paddygoat/WEEDINATOR_2026/Code/Control_room/small-tractor-transparent-background_02.png

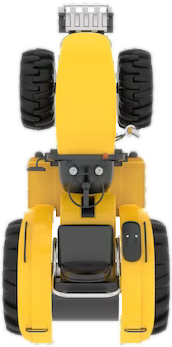
Code/Control_room/small-tractor-transparent-background_02.png
