paddygoat/WEEDINATOR_2026/Code/Control_room/tiles/tile_workshop.jpg

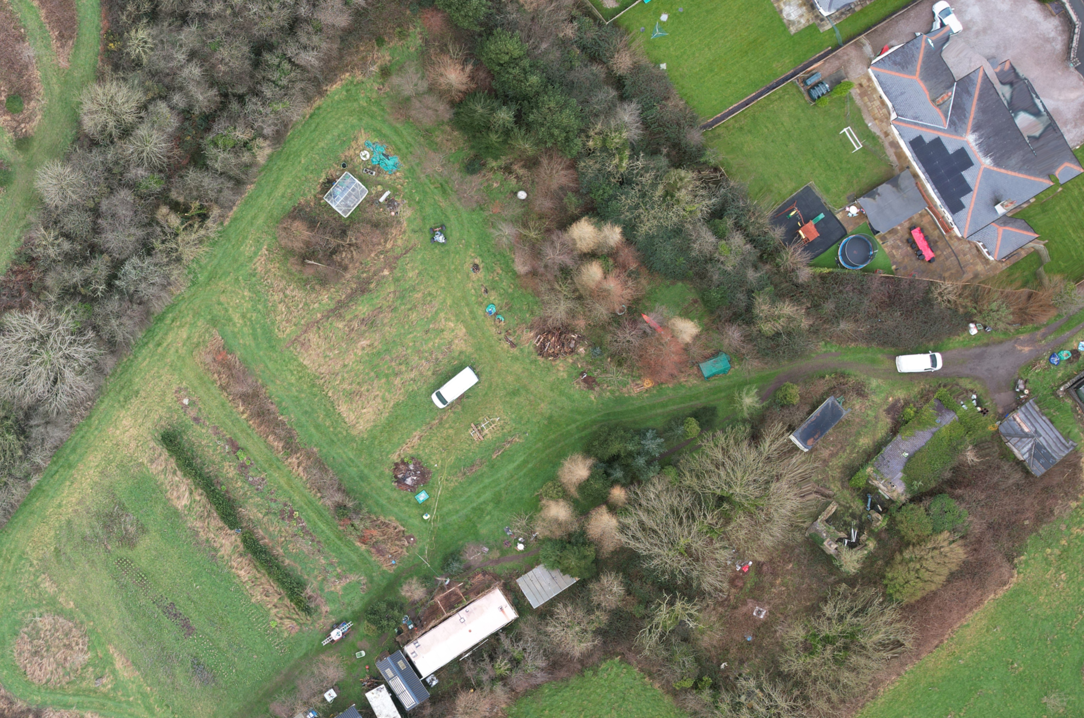
Code/Control_room/tiles/tile_workshop.jpg
