paddygoat/WEEDINATOR_2026/Cultivation_implement/CAD_files/data_sheets/HGL30CAZ0H_block_01.png

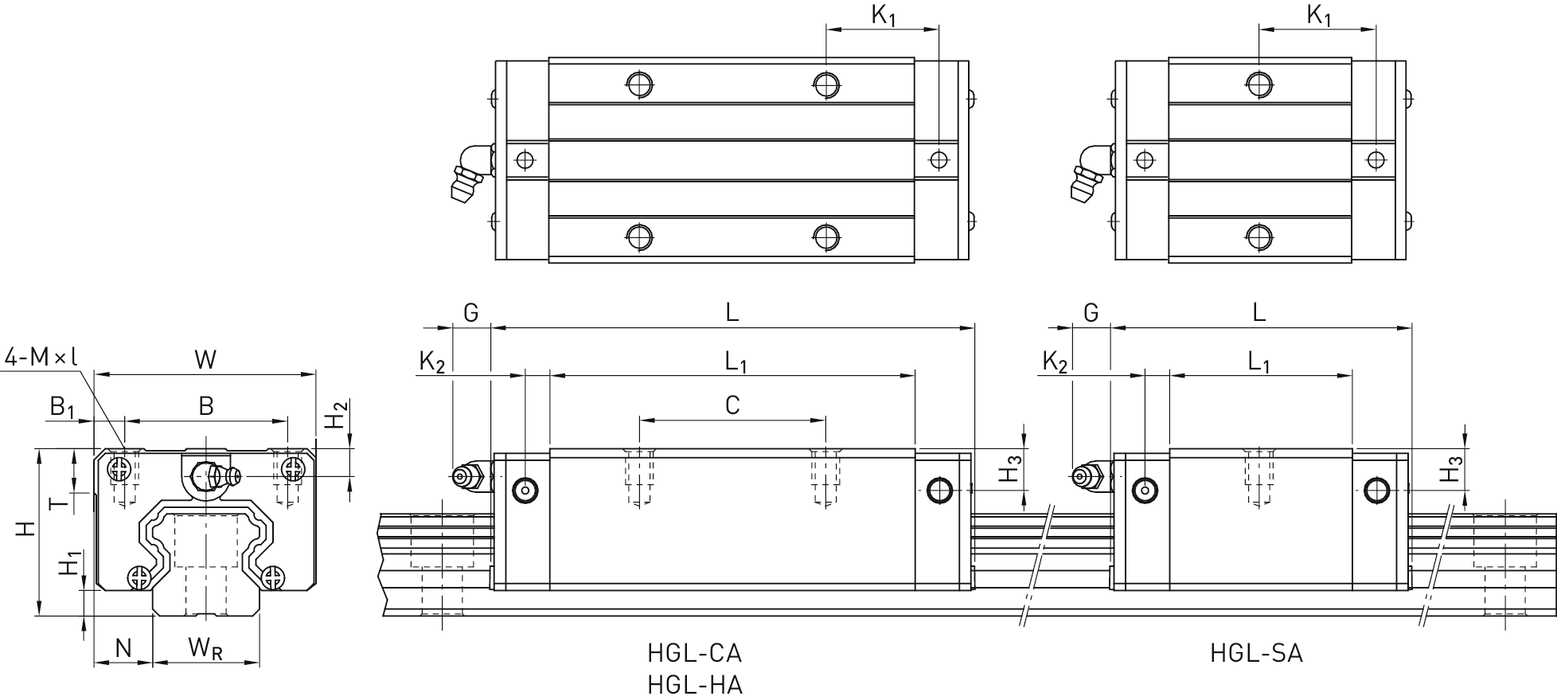
Cultivation_implement/CAD_files/data_sheets/HGL30CAZ0H_block_01.png
