paddygoat/WEEDINATOR_2026/Hydraulics/hydraulic_circuit_06.png

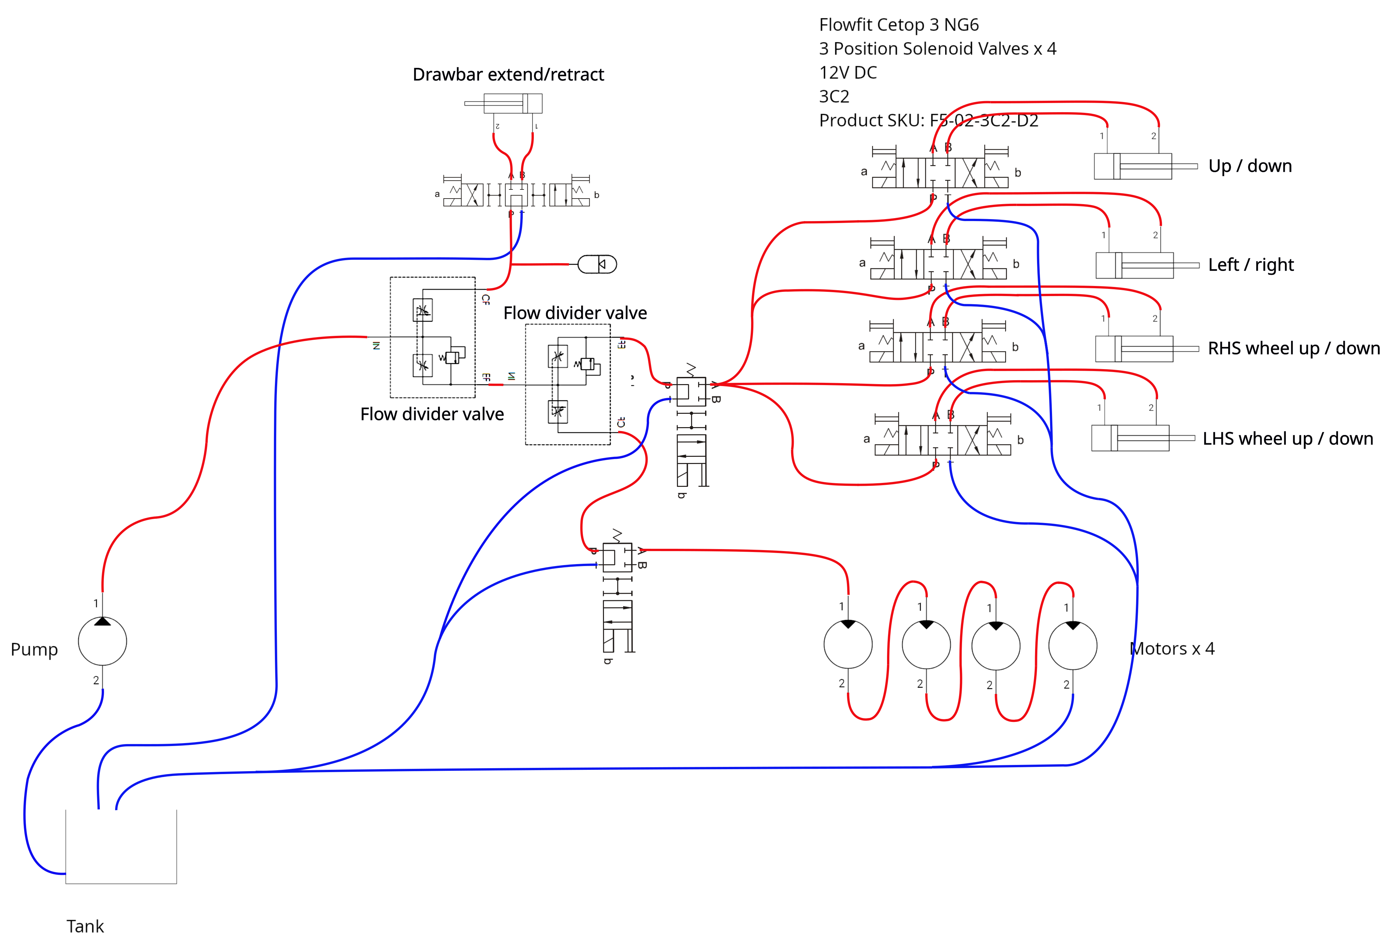
Hydraulics/hydraulic_circuit_06.png
