paddygoat/WEEDINATOR_2026/Models/green_leaf_01.png

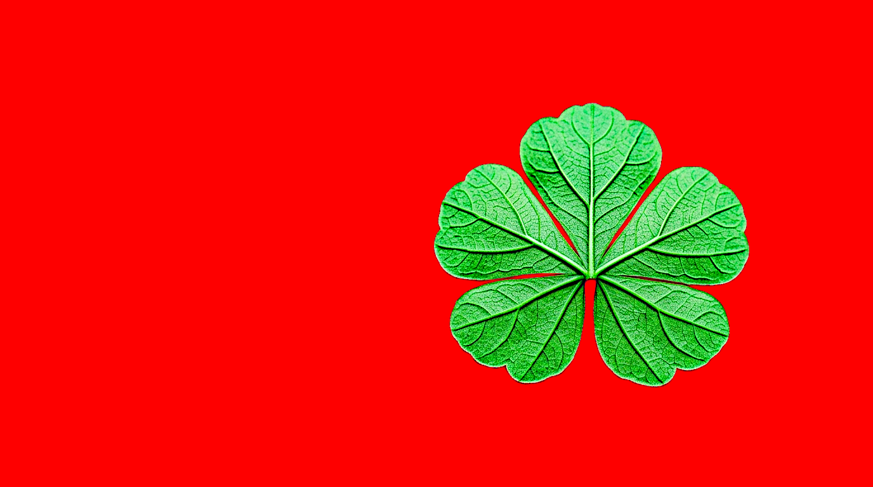
Models/green_leaf_01.png
