paddygoat/WEEDINATOR_2026/UBLOX_GPS_modules/ublow_data_flow_02.jpg

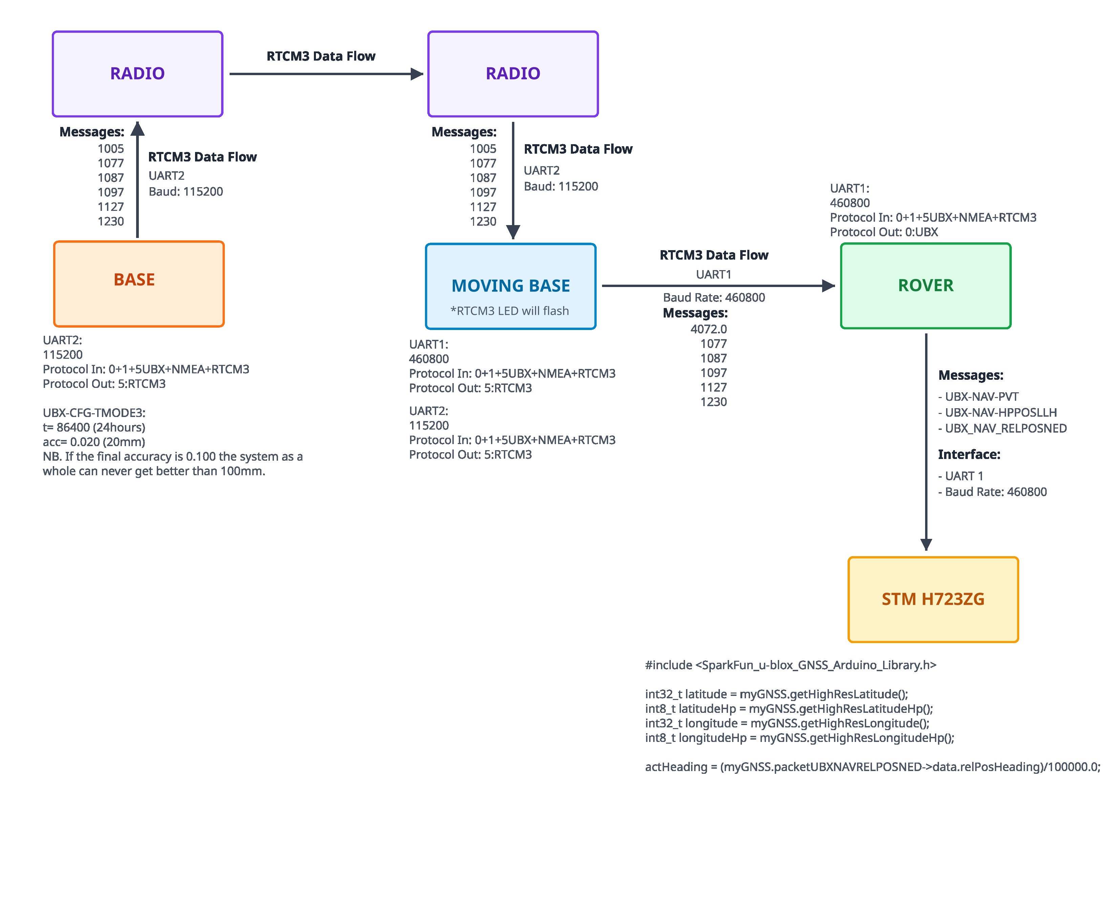
UBLOX_GPS_modules/ublow_data_flow_02.jpg
