paddygoat/WEEDINATOR_2026/Cultivation_implement/CAD_files/data_sheets/Linear Guide Rail HGR30.png

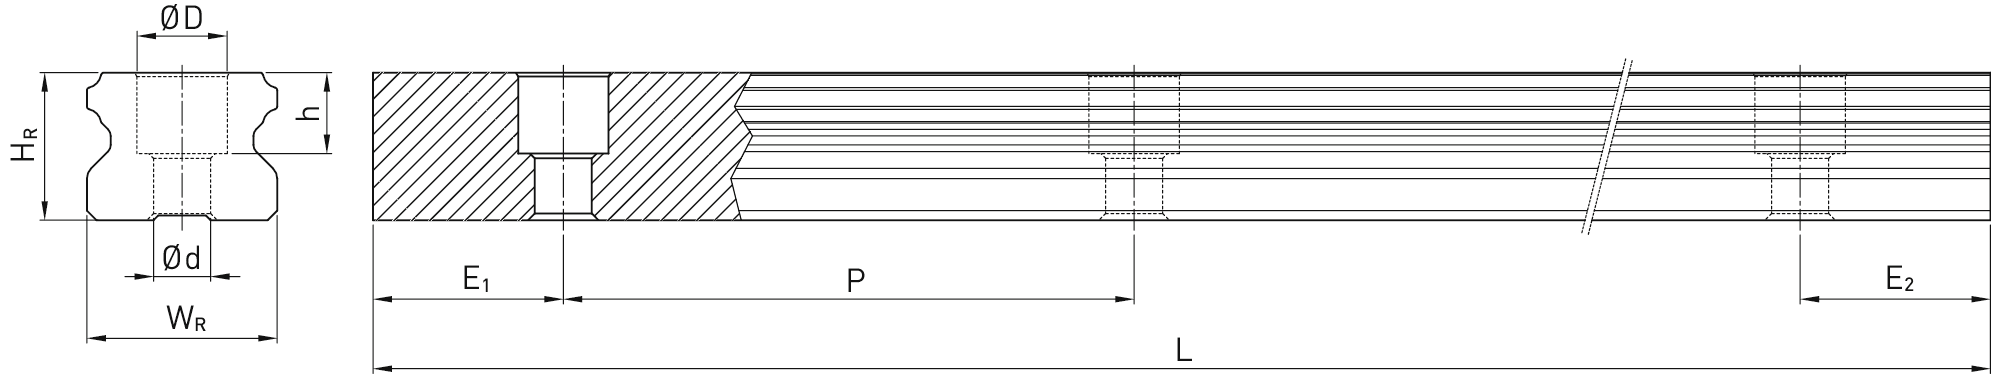
Cultivation_implement/CAD_files/data_sheets/Linear Guide Rail HGR30.png
