paddygoat/WEEDINATOR_2026/(list of files, drawings)

Other design files:
PCBs/Jetson_nano_40_pin_breakout_board_01.pcb
PCBs/WEEDINATOR _base_PCB_02.pcb
PCBs/WEEDINATOR _base_PCB_03.pcb
PCBs/WEEDINATOR _gland_housing_03.pcb
PCBs/WEEDINATOR _gland_housing_04.pcb
PCBs/WEEDINATOR _gland_housings_05.pcb
PCBs/WEEDINATOR _gland_housings_05a.pcb
PCBs/WEEDINATOR _gland_housings_05b.pcb
PCBs/WEEDINATOR _gland_housings_05c.pcb
PCBs/WEEDINATOR _PCB_05_GPS_daughter_board.pcb
PCBs/WEEDINATOR _PCB_07_mcu.pcb
PCBs/WEEDINATOR _PCB_08_relays.pcb
PCBs/WEEDINATOR _PCB_HIGH_SIDE_SWITCHES_02.pcb
PCBs/WEEDINATOR _RPI_Jetson_Technexion_mount_01.pcb
