paddygoat/WEEDINATOR_2026/Code/STM32/WEEDINATOR_TF321_2026_BOX1/buzzLED.h

#ifndef BUZZLED_H
#define BUZZLED_H

#include "pins.h"

extern void buzz();
extern void beep();
extern void flash_all_LEDs();
extern void blink_green_LED();
extern void delay_with_text_10sec();
extern void delay_with_text_1sec();


#endif
