paddygoat/WEEDINATOR_2026/(commit log)

2026-08-30 Document Dual Vision Pipeline Architecture in README
    Added detailed section on Dual Vision Pipeline Architecture explaining the predictive crop row tracking system, including components, spatial coordinate extraction, sensor fusion, and event validation.
2026-08-30 Remove extensive sections from README.md
    Removed detailed sections on Dual Vision Pipeline Architecture, Sensor Fusion, Detection Merging, and Edge Case Handling from the README.
2026-08-30 Add README documentation for Touch Screen App
    Added detailed documentation for the Dual Vision Pipeline Architecture, including system components, spatial coordinate extraction, sensor fusion, event validation, predictive modeling, and edge case handling.
